zachariahsharma/puck/production/Puck_0.5.0_bom.csv

Designator | Footprint | Quantity | Value | LCSC Part #
C1 | C_0603 | 1 | 1 uF | C15849
C2 | C_0603 | 1 | 100nF | C19702
C3 | C_0603 | 1 | 4.7uF | C19702
C4 | C_0603 | 1 | 10uF | C19702
C5 | C_0603 | 1 | 1uF | C15849
C6 | C_0805 | 1 | 100nF | C28233
C7 | C_0603 | 1 | .1uF | C19702
J3 | HRO_TYPE-C-31-M-12 | 1 | TYPE-C-31-M-12 | C165948
LED1 | LED-SEG-TH_10P-L25.0-W19.0-P2.54-S15.2-BL | 1 | SN760561W/16 | C2980912
R3, R4 | R_0402 | 2 | 4.7kΩ | C25900
R5, R6 | R_0603 | 2 | 5.1kΩ | C23186
R7 | R_0603 | 1 | 10kΩ | C25804
SW1, SW2 | SW_PUSH_6mm_H7.3mm | 2 | SW_Push | B3F-4055
U1 | SOP-16_L10.0-W3.9-P1.27-LS6.0-BL | 1 | ET6226M | C347308
U3 | ESP32-C6-MINI-1 | 1 | ESP32-C6-MINI-1 | C5736265
U4 | SOT95P285X140-5N | 1 | AP2112K-3.3TRG1 | C51118
U5 | SOP65P490X110-8N | 1 | MCP9808T-E_MS | C129490
