zachariahsharma/puck/Comps/Models/ESP32-C6-MINI-1.STEP

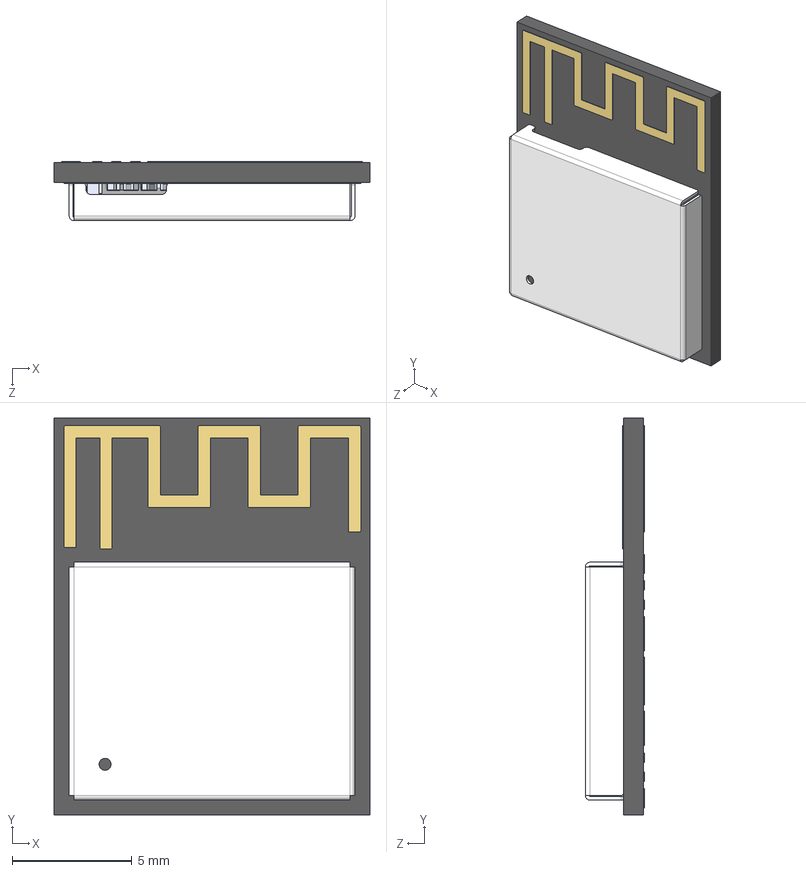
[picture p3: CAD file, 2026-06-09]
Comps/Models/ESP32-C6-MINI-1.STEP
13.2 x 16.6 x 2.48 mm
uid__2428
R0201_20210301.xtd x 3
L0201_20210301.xtd x 2
C0201_20210301.xtd x 10
ESP32-C6_QFN32_5X5_202306.xtd
XTAL3225_20210301.xtd
DFN1006.xtd
C0402_20210301.xtd
placementOutline_18
placementOutline_19
placementOutline_20
placementOutline_21
placementOutline_22
placementOutline_23
placementOutline_24
MINI-ANT-TYPE-D-H-top
MINI-ANT-TYPE-D-H-buttom
C3-MINI-solder_pad
ShieldBox_ESP32-C3-MINI-1_V1.0_20200901
