zachariahsharma/puck/Comps/Models/CP2102N-A02-GQFN28R.step

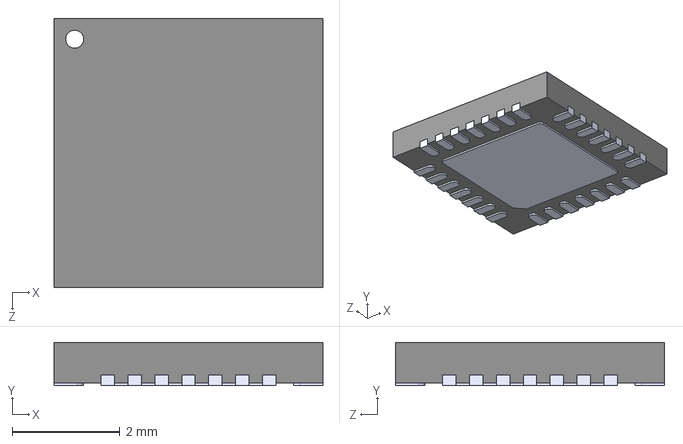
[picture p4: CAD file, 2026-04-08]
Comps/Models/CP2102N-A02-GQFN28R.step
5.00 x 0.8 x 5.00 mm
