zachariahsharma/puck/Comps/Models/AP2112K-3.3TRG1.step

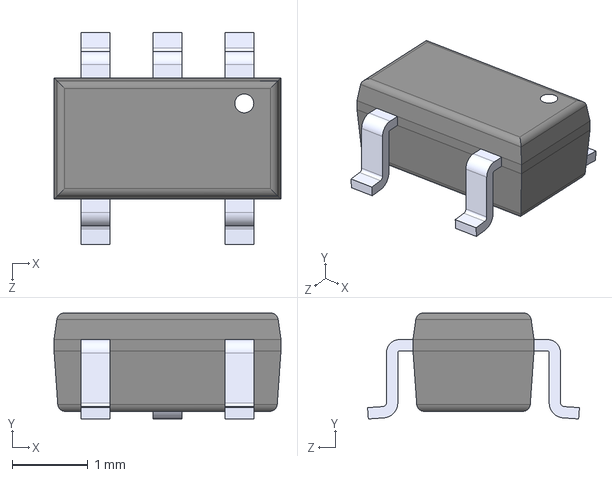
[picture p5: CAD file, 2026-04-08]
Comps/Models/AP2112K-3.3TRG1.step
3.00 x 1.40 x 2.80 mm
