zachariahsharma/puck/Comps/Models/TYPE-C-31-M-12.step

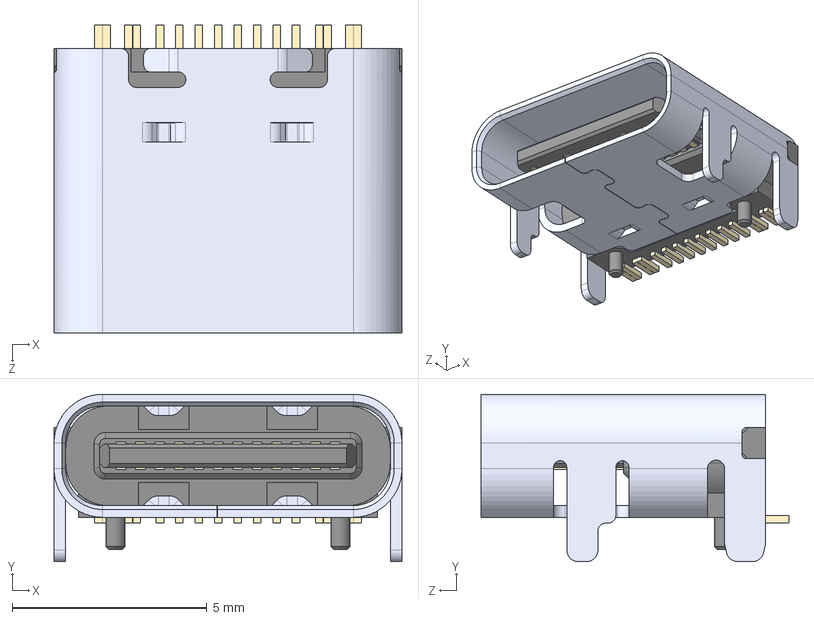
[picture p6: CAD file, 2026-04-08]
Comps/Models/TYPE-C-31-M-12.step
8.94 x 4.30 x 7.90 mm
