zachariahsharma/puck/Comps/Models/MCP9808T-E_MS.step

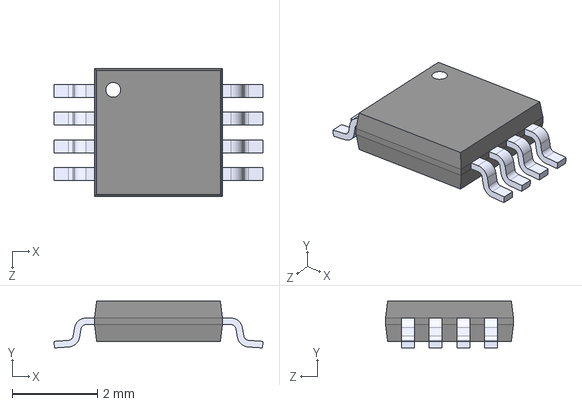
[picture p7: CAD file, 2026-04-08]
Comps/Models/MCP9808T-E_MS.step
4.90 x 1.10 x 3.00 mm
