zachariahsharma/puck/Puck.kicad_pcb

## KiCad design Puck.kicad_pcb (2026-10-26)

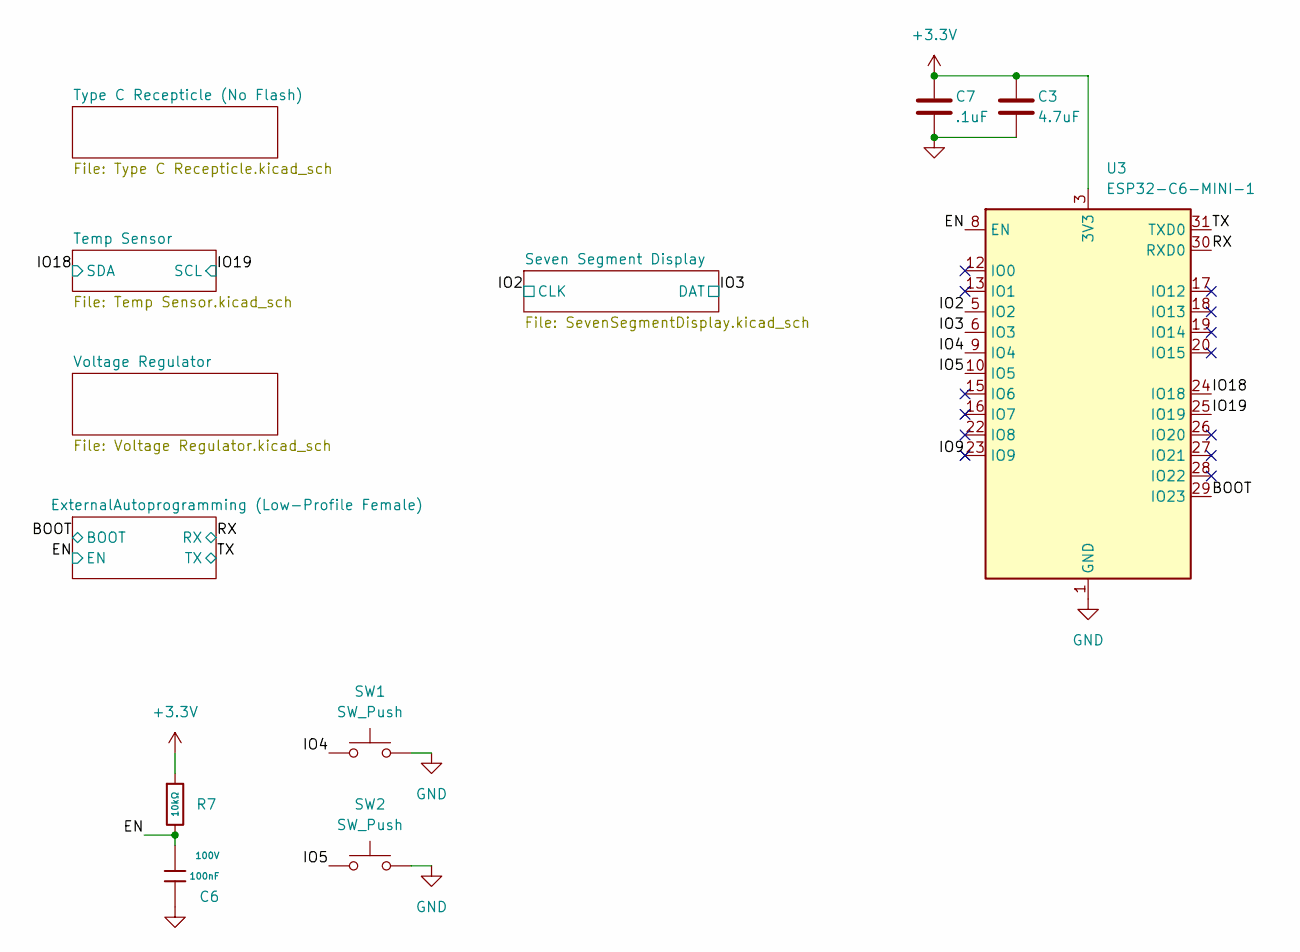
[picture p8: schematic Puck.kicad_sch, Vynte Puck]

Parts:
C3: 4.7uF; C_0603; MPN CL10A475KO8NNNC; DigiKey 1276-1784-2-ND
C6: 100nF; C_0805; Voltage Rated 100V; Tolerance ±10%; MPN CL21B104KCFNNNE; LCSC C28233
C7: .1uF; C_0603; MPN CL10B104KB8NNNC; DigiKey 1276-1000-2-ND
R7: 10kΩ; R_0603; Overload Voltage (Max) 75V; Tolerance ±1%; MPN 0603WAF1002T5E; LCSC C25804
SW1, SW2: SW_Push; SW_PUSH_6mm_H7.3mm; MPN B3F-4055; DigiKey SW414-ND
U3: ESP32-C6-MINI-1; MPN ESP32-C6-MINI-1-N4; LCSC C5736265

Connections:
+3.3V: C3.1, C7.1, R7.1, U3.3 (3V3); also elsewhere on the board
/BOOT: U3.29 (IO23); also elsewhere on the board
/EN: C6.1, R7.2, U3.8 (EN); also elsewhere on the board
/IO2: U3.5 (IO2); also elsewhere on the board
/IO3: U3.6 (IO3); also elsewhere on the board
/IO4: SW1.1, U3.9 (IO4)
/IO5: SW2.1, U3.10 (IO5)
/IO9: U3.23 (IO9)
/IO18: U3.24 (IO18); also elsewhere on the board
/IO19: U3.25 (IO19); also elsewhere on the board
/RX: U3.30 (RXD0); also elsewhere on the board
/TX: U3.31 (TXD0); also elsewhere on the board
GND: C3.2, C6.2, C7.2, SW1.2, SW2.2, U3.1 (GND), U3.2 (GND), U3.11 (GND), U3.14 (GND), U3.36 (GND), U3.37 (GND), U3.38 (GND), U3.39 (GND), U3.40 (GND), U3.41 (GND), U3.42 (GND), U3.43 (GND), U3.44 (GND), U3.45 (GND), U3.46 (GND), U3.47 (GND), U3.48 (GND), U3.49 (GND), U3.50 (GND), U3.51 (GND), U3.52 (GND), U3.53 (GND); also elsewhere on the board

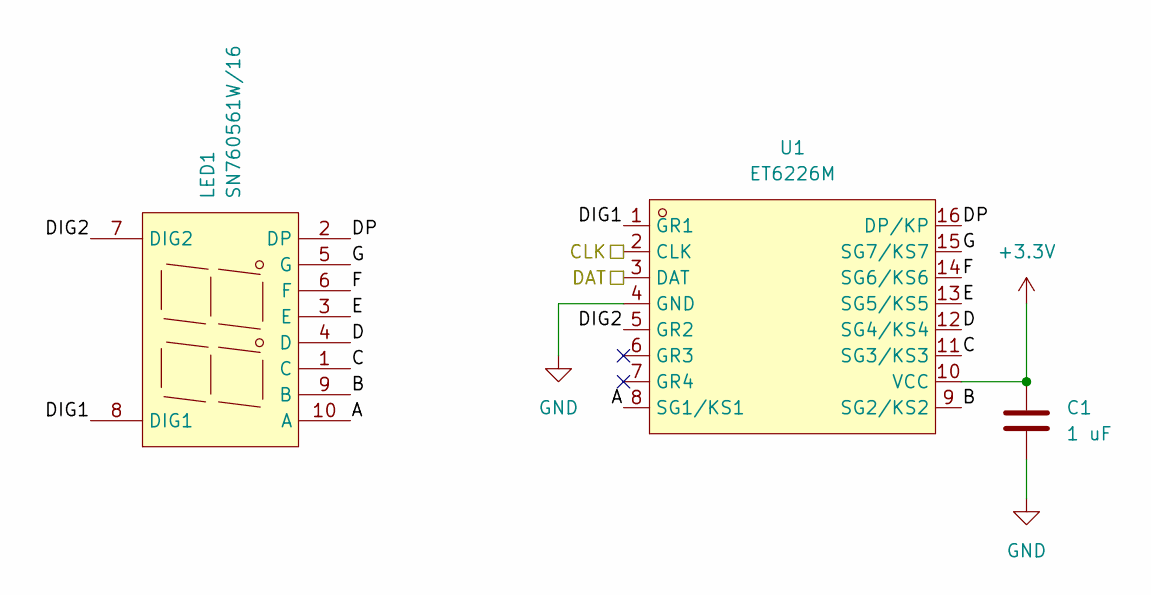
[picture p9: schematic SevenSegmentDisplay.kicad_sch]

Parts:
C1: 1 uF; C_0603; MPN CL10A105KB8NNNC; LCSC C15849
LED1: SN760561W/16; LED-SEG-TH_10P-L25.0-W19.0-P2.54-S15.2-BL; MPN SN760561W/16; LCSC C2980912
U1: ET6226M; SOP-16_L10.0-W3.9-P1.27-LS6.0-BL; MPN ET6226M; LCSC C347308

Connections:
+3.3V: C1.1, U1.10 (VCC); also elsewhere on the board
/IO2: U1.2 (CLK); also elsewhere on the board
/IO3: U1.3 (DAT); also elsewhere on the board
/Seven Segment Display/A: LED1.10 (A), U1.8 (SG1/KS1)
/Seven Segment Display/B: LED1.9 (B), U1.9 (SG2/KS2)
/Seven Segment Display/C: LED1.1 (C), U1.11 (SG3/KS3)
/Seven Segment Display/D: LED1.4 (D), U1.12 (SG4/KS4)
/Seven Segment Display/DIG1: LED1.8 (DIG1), U1.1 (GR1)
/Seven Segment Display/DIG2: LED1.7 (DIG2), U1.5 (GR2)
/Seven Segment Display/DP: LED1.2 (DP), U1.16 (DP/KP)
/Seven Segment Display/E: LED1.3 (E), U1.13 (SG5/KS5)
/Seven Segment Display/F: LED1.6 (F), U1.14 (SG6/KS6)
/Seven Segment Display/G: LED1.5 (G), U1.15 (SG7/KS7)
GND: C1.2, U1.4 (GND); also elsewhere on the board

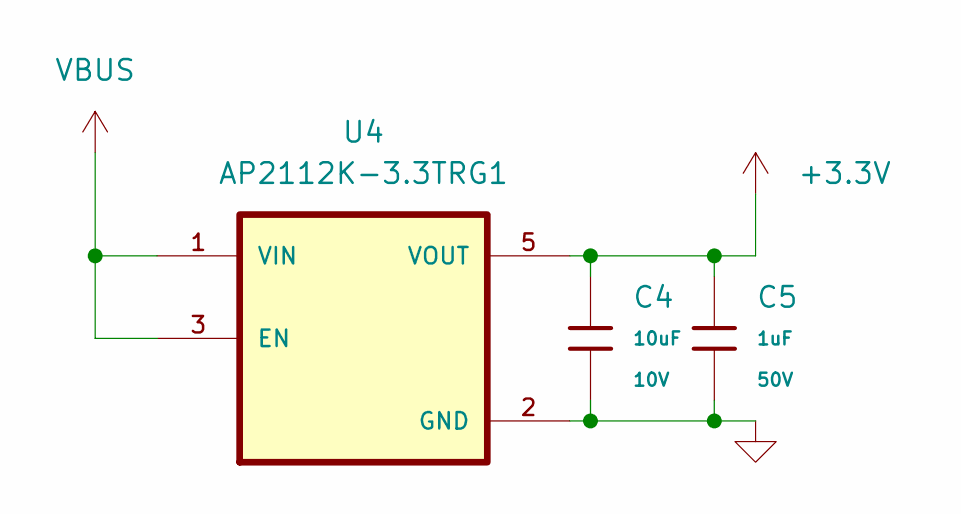
[picture p10: schematic Voltage Regulator.kicad_sch]

Parts:
C4: 10uF; C_0603; Voltage Rated 10V; Tolerance ±10%; MPN CL10A106KP8NNNC; LCSC C19702
C5: 1uF; C_0603; Voltage Rated 50V; Tolerance ±10%; MPN CL10A105KB8NNNC; LCSC C15849
U4: AP2112K-3.3TRG1; SOT95P285X140-5N; MPN AP2112K-3.3TRG1; LCSC C51118

Connections:
+3.3V: C4.1, C5.1, U4.5 (VOUT); also elsewhere on the board
GND: C4.2, C5.2, U4.2 (GND); also elsewhere on the board
VBUS: U4.1 (VIN), U4.3 (EN); also elsewhere on the board

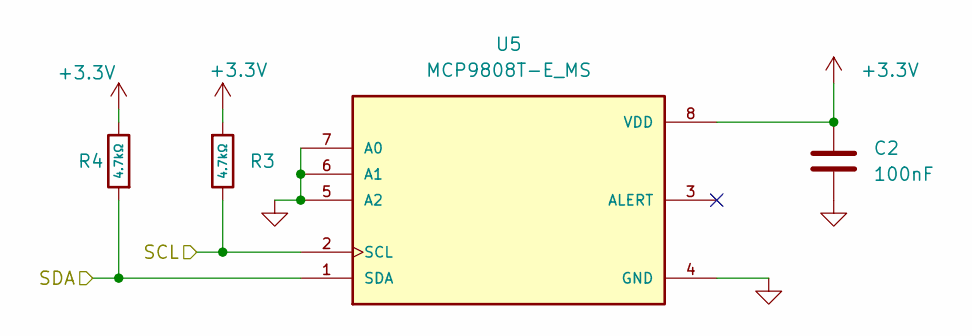
[picture p11: schematic Temp Sensor.kicad_sch]

Parts:
C2: 100nF; C_0603; MPN CL10B104KB8NNNC; DigiKey 1276-1000-2-ND
R3, R4: 4.7kΩ; R_0402; Overload Voltage (Max) 50V; Tolerance ±1%; MPN 0402WGF4701TCE; LCSC C25900
U5: MCP9808T-E_MS; SOP65P490X110-8N; MPN MCP9808T-E/MS; LCSC C129490

Connections:
+3.3V: C2.1, R3.1, R4.2, U5.8 (VDD); also elsewhere on the board
/IO18: R4.1, U5.1 (SDA); also elsewhere on the board
/IO19: R3.2, U5.2 (SCL); also elsewhere on the board
GND: C2.2, U5.4 (GND), U5.5 (A2), U5.6 (A1), U5.7 (A0); also elsewhere on the board

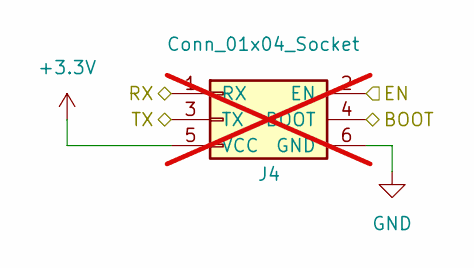
[picture p12: schematic ExternalAutoprogramming.kicad_sch]

Parts:
J4: Conn_01x04_Socket; Tag-Connect_TC2030-IDC-NL_2x03_P1.27mm_Vertical; not fitted

Connections:
+3.3V: J4.5 (VCC); also elsewhere on the board
/BOOT: J4.4 (BOOT); also elsewhere on the board
/EN: J4.2 (EN); also elsewhere on the board
/RX: J4.1 (RX); also elsewhere on the board
/TX: J4.3 (TX); also elsewhere on the board
GND: J4.6 (GND); also elsewhere on the board

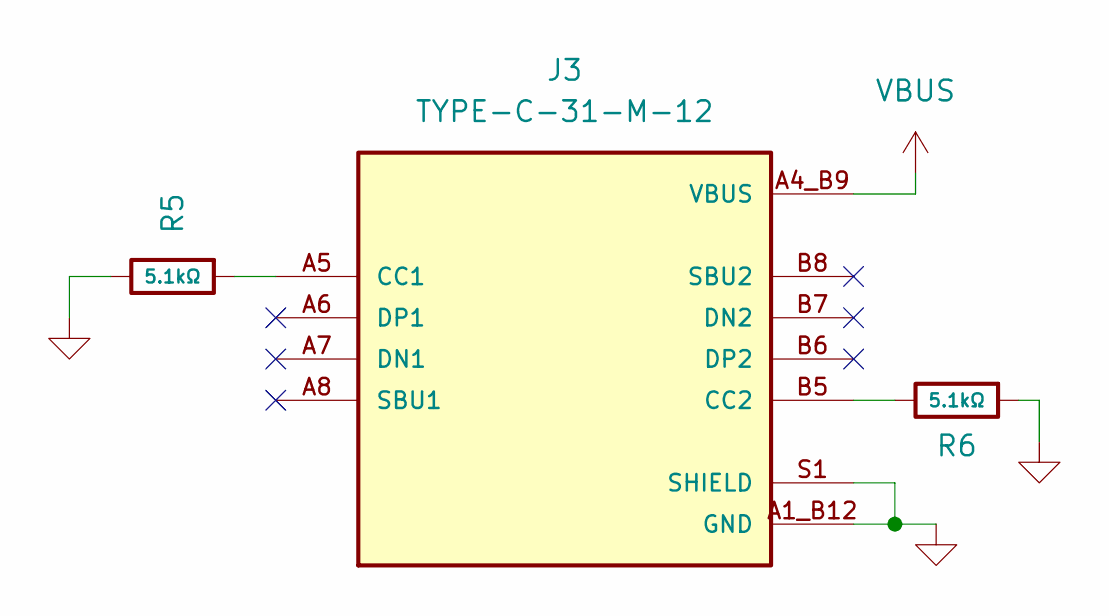
[picture p13: schematic Type C Recepticle.kicad_sch]

Parts:
J3: TYPE-C-31-M-12; HRO_TYPE-C-31-M-12; MPN TYPE-C-31-M-12; LCSC C165948
R5, R6: 5.1kΩ; R_0603; Overload Voltage (Max) 75V; Tolerance ±1%; MPN 0603WAF5101T5E; LCSC C23186

Connections:
GND: J3.A1_B12 (GND), J3.B1_A12 (GND), J3.S1 (SHIELD), J3.S2 (SHIELD), J3.S3 (SHIELD), J3.S4 (SHIELD), R5.2, R6.1; also elsewhere on the board
unnamed: J3.A5 (CC1), R5.1
unnamed: J3.B5 (CC2), R6.2
VBUS: J3.A4_B9 (VBUS), J3.B4_A9 (VBUS); also elsewhere on the board

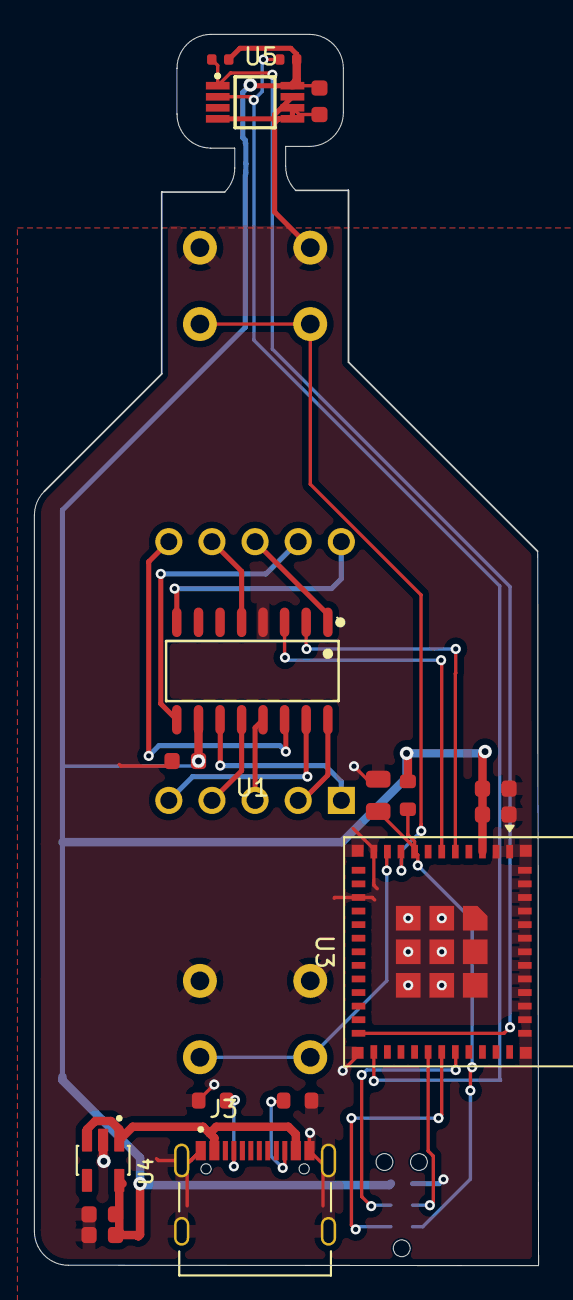
[picture p14: board Puck.kicad_pcb from above]

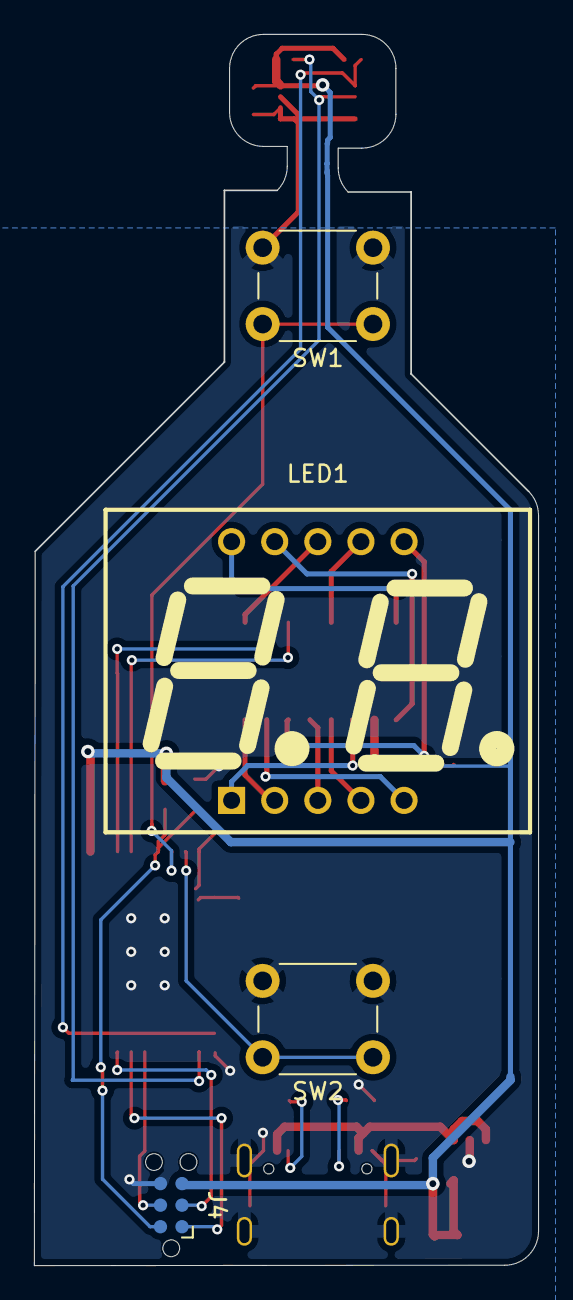
[picture p15: board Puck.kicad_pcb from below]

Board: 4 copper layers, 29.7 x 72.5 mm, 21 parts (4 on the bottom side), 25 nets.
