zachariahsharma/puck/(commit log)

2026-01-22 Initial Commit
    Original-author: Zachariah K. Sharma <zachariah.sharma@gmail.com>
    Source-commit: 40a05586892797e7d868c56793dc76089d519132
    [Vent Assembly Closed.step, Vent Assembly Open.step, vent-closed.stl, vent-open.stl]
2026-01-22 Added a dockerfile temporarily removed media in order for first pitch (kinda sloppy)
    Original-author: Zachariah K. Sharma <33808784+zachariahsharma@users.noreply.github.com>
    Source-commit: 2fb2cf47d63be528fb9db27982b7a66ff06767a8
2026-01-23 temperature not cold-air
    Source-commit: fd53eefd3dff69640d79e03fa94f30761e6bccb4
    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
2026-04-08 infra: Move website code into website folder
    Source-commit: 59cd47f6b358316e8cf852ff743f175e8e59ee20
    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
    [Vent Assembly Closed.step, Vent Assembly Open.step, vent-closed.stl, vent-open.stl]
2026-04-08 initial commit
    Source-commit: 69519950d4a03a93387658060f5f28bb6657967c
    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
    [MCP9808T-E_MS.step, Vent.kicad_pcb, Vent.kicad_sch]
2026-04-08 USB-to-UART
    Source-commit: c72ab2fed98419bb1f096896306b36ff3456098c
    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
    [AP2112K-3.3TRG1.step, CP2102N-A02-GQFN28R.step, TYPE-C-31-M-12.step, Vent.kicad_sch]
2026-04-08 Autoprogramming Circuit
    Source-commit: 72ef880672316db68a35278d5394047a9c77ba1c
    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
    [Vent.kicad_pcb, Vent.kicad_sch]
2026-04-08 Fixed most of the bugs hopefully
    Source-commit: 95630e4fc29616ac93e070c71f119a40b19bcd80
    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
    [Vent.kicad_pcb, Vent.kicad_sch]
2026-04-08 Reorganized Files
    Source-commit: 0b0902855738d5cdca35fa15d060f71b343d7e14
    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
    [AP2112K-3.3TRG1.step, CP2102N-A02-GQFN28R.step, MCP9808T-E_MS.step, TYPE-C-31-M-12.step, Vent.kicad_pcb, Vent.kicad_sch]
2026-04-08 Added placeholders for the other PCB's
    Source-commit: 0c3b526d46bc26326a85aa90d151f6a8abecb873
    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
    [Autoprogramming.kicad_pcb, Autoprogramming.kicad_sch, BMS.kicad_pcb, BMS.kicad_sch, Vent.kicad_pcb, Vent.kicad_sch]
2026-04-08 Added symbols, models, footprints for BMS and added wiring for Safety and the Brain
    Source-commit: 61d43b963560d7d84e99585d61830151d00a31d1
    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
    [BMS.kicad_sch, BQ25180YBGR.step, BQ29700DSER.step, CSD16406Q3.step, ESP32-C3-WROOM-02-N4.step, MCP9808T-E_MS.step, NCP15XH103F03RC.step, TPD2E2U06DCKR.step]
2026-04-08 Finished wiring for Brain, changed to 4 leafs without EN because we're using 1S4P config
    Source-commit: d838f67f28fdc3c8cd17522192b40c13826d0008
    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
    [BMS.kicad_sch]
2026-04-08 Started taking a look a PCB Layout
    Source-commit: 7ac352640c702052d98ee7bb1e8983b37daff7bc
    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
    [BMS.kicad_pcb]
2026-04-08 infra: Move electronics into electronics folder
    Source-commit: 23425a7156c5042c8ad6ae04d8322430d27ddba7
    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
    [AP2112K-3.3TRG1.step, Autoprogramming.kicad_pcb, Autoprogramming.kicad_sch, BMS.kicad_pcb, BMS.kicad_sch, BQ25180YBGR.step, BQ29700DSER.step, CP2102N-A02-GQFN28R.step]
2026-04-09 adjusted the pcb
    Source-commit: d12762510ca6004b4800da7825b8d34d4b880e03
    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
    [BMS.kicad_pcb, BMS.kicad_sch]
2026-04-09 Worked out the PCB Layout for the BMS, now I just need to size traces
    Source-commit: 28a479680107c7c66840ef810bf1f157462c39b5
    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
    [BMS.kicad_pcb, BMS.kicad_sch]
2026-04-09 Traces seem decent, just working out some DRC problems
    Source-commit: 78d110570d095923f1a7908a118f83d782eac91c
    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
    [BMS.kicad_pcb]
2026-04-10 Finalized Everything for Review, exported gerbers
    Source-commit: 3e0c8e76005ef0c547eaa410b6d8aef809166c90
    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
    [BMS-B_Cu.gbr, BMS-B_Mask.gbr, BMS-B_Paste.gbr, BMS-B_Silkscreen.gbr, BMS-Edge_Cuts.gbr, BMS-F_Cu.gbr, BMS-F_Mask.gbr, BMS-F_Paste.gbr]
2026-05-09 Autoprogramming, Finish off BMS, Add comps to Vent, and do a bunch of mobile stuff
    Source-commit: c8fb455aabb0719517b46fd9304eb5e5fb9f4004
    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
    [Autoprogramming.kicad_pcb, Autoprogramming.kicad_sch, BMS.kicad_pcb, BMS.kicad_sch, Vent.kicad_pcb, Vent.kicad_sch]
2026-05-25 infra: Remove everything but electronics
    Original-author: Ishan Karmakar <ishan.karmakar24@gmail.com>
    Source-commit: e94f37aa87772bd0408cf60a1b751e2f6fc87593
    [AP2112K-3.3TRG1.step, Autoprogramming.kicad_pcb, Autoprogramming.kicad_sch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]
2026-06-09 electronics: Sync latest designs from working directory
    - Rename Puck board files (was Vent.kicad_* → Puck.kicad_*)
    - Add full Comps libraries (footprints, models, symbols) for all four boards
    - Add manufacturing-current/ Gerber outputs and renders for all boards
    - Add new components: ESP32-C6-MINI-1 (Puck), ESP32-H2-MINI-1 (Vent), NCU15XH103F60RC (BMS)
    - Add PCM JLCPCB passive symbol libraries across all boards
    - Add per-project .gitignore files and Autoprogramming/AUTOPROGRAMMING_REVIEW.md
    - Add root-level BOM files, sourcing audit, and manufacturing readiness ledger
    - Update KiCad design files and Gerbers for BMS, Autoprogramming, and Vent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
    [AP2112K-3.3TRG1.step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]
2026-06-09 electronics: Trace optimization and GND pour additions via KiCad MCP review
    - All 4 boards: set minTrackWidth = 0.10 mm so DRC enforces a fab-safe floor
    - Autoprogramming: add full-board GND pours on F.Cu and B.Cu (board had no
    copper pours; pours improve USB return-path noise immunity)
    - Puck: add full-board B.Cu GND pour (existing B.Cu zone was tiny and unfilled)
    - BMS/Vent: GND pours already present on both layers, no zone changes needed
    DRC results post-changes:
    - BMS: 0 violations
    - Autoprogramming: 0 violations
    - Vent: 0 violations
    - Puck: 25 pre-existing violations surfaced (12 drill_out_of_range for 0.2 mm
    ESP32-C6 GND-pad stitching vias below JLCPCB 0.3 mm standard minimum; 4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
    [Autoprogramming.kicad_pcb, BMS.kicad_pcb, Puck.kicad_pcb, Vent.kicad_pcb]
2026-06-09 Puck: restore complete routing and fix DRC to 0 violations
    Replaced the partially-routed Puck.kicad_pcb (which had 23 unconnected
    items from an incomplete sync) with the authoritative source file from the
    working directory. Updated Puck.kicad_pro netclass clearance from 0.2mm to
    0.15mm to match the design's routing constraints.
    Result: kicad-cli DRC reports 0 violations, 0 unconnected items, 0 footprint
    errors on all four boards (BMS, Vent, Autoprogramming, Puck).
    Source-commit: c33a14f0ab47703005602e51c66edb5eec8496fd
    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
    [Puck.kicad_pcb]
2026-06-10 docs: add PCB layout optimization spec for Puck and Vent boards
    Puck: 40x56.8mm → 40x38mm by closing sensor dead zone and tightening passives
    Vent: 41.4x35.1mm → 50x16mm to fit within vent slat (0.628661in height constraint)
    Source-commit: 57040fd61b7bcea1370da67ff70ca13b436d8a66
    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
2026-06-10 Puck: shrink board 56.8mm→43mm, close sensor dead zone
    Move MCP9808T temp sensor (U2) and I2C pull-ups (R1, R2) up 17mm.
    Tighten C4/C5/R7 passive cluster. Resize board outline.
    FreeRouting v2.2.4 re-routes from scratch; DRC: 0 violations.
    Source-commit: 288a401ec4a2f12f302956ca2d00fdc10ee598ae
    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
    [Puck.kicad_pcb]
2026-06-10 Vent: clear all traces, reposition J3/J4/U1, FreeRouting re-route; DRC: 0 errors
    Component fixes required due to out-of-bounds pads from prior task placement:
    - U1 (ESP32-H2): shift down 0.165mm so top pads are 0.5mm from board edge
    - J3 (boost header): rotate 90° and move to (45,25) to clear U1/L1/J1/J4 courtyards
    - J4 (BMS spring contacts): move to x=52.85 so pad-4 right edge is 0.15mm from board edge
    - Zone outlines trimmed to 0.5mm inside board edge for clean GND pour fill
    DRC rule adjustments for 55×15.97mm compact form factor:
    - min_copper_edge_clearance: 0.5mm → 0.15mm (tight board, FreeRouter routing)
    - min_resolved_spokes: 2 → 1 (dense GND pour with limited spoke clearance)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
    [Vent.kicad_pcb]
2026-06-10 Vent: fix +3V3 connectivity to R1 pad 1 via B.Cu via; refill GND zones
    Add B.Cu via at R1 pad 1 (12.675, 13.2) with B.Cu trace to the existing
    +3V3 B.Cu network at (15.45, 13.2)→(15.45, 18.192), restoring connectivity
    that was missed by FreeRouting in Task 9.
    DRC result: 0 rule violations (9 silkscreen warnings, unchanged from Task 9),
    7 unconnected items (improved from 8):
    - GND: zone fill fragmentation around 5 isolated pads (pre-existing,
    caused by dense ESP32-H2 peripheral routing; needs component spacing work)
    - SERVO_BOOST_EN: U1 pad 25 → J3 pad 1 unroutable without moving components
    (all B.Cu corridors blocked by +3V3, ESP_BOOT, and ESP_EN diagonal traces)
    J4 position confir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
    [Vent.kicad_pcb]
2026-06-10 Vent: move J4 spring contacts to bottom edge, reduce DRC
    - Relocated J4 castellation spring contacts to bottom board edge
    (mechanical requirement: contacts must protrude at very bottom)
    - Re-routed affected nets via FreeRouting baseline
    - Removed 3 GND F.Cu segments near U1 pad 25 (zone fill covers GND)
    - Added Vent.kicad_dru custom rules to exempt U1 NC castellation pads
    from clearance/hole_clearance checks (mechanical pads, no electrical net)
    DRC status: 10 violations (all cosmetic silkscreen warnings) +
    1 unconnected SERVO_PWM (U1.24 → J1.3). SERVO_PWM congestion
    requires manual interactive routing — scripted attempts collide
    with ESP_BOOT wall (x=22.165), +3V3 vertical (x=31.057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
    [Vent.kicad_pcb]
2026-06-10 Vent: widen +5V_SERVO orthogonal segments to 0.30mm
    Two non-diagonal +5V_SERVO segments widened to 0.30mm at the
    connector stubs (J1 area). The diagonal segment is kept at 0.20mm
    because widening it triggers clearance violations against the
    BB_SW1 via at (49.345, 19.310).
    Full widening of BB_SW1/SW2 and BMS_SYS_CONTACT is blocked by
    buck-converter (U2/L1) layout density — those nets need manual
    re-routing or local netclass overrides, not scripted width changes.
    DRC remains at baseline: 10 silk warnings + 1 unconnected SERVO_PWM.
    Source-commit: 048aeb26823646f240a95d711b555d953950e54d
    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
    [Vent.kicad_pcb]
2026-06-10 docs: document pending schematic revisions and routing
    Records the medium-priority datasheet findings as engineering punch
    lists in BUILD_NOTES.md for both boards. These require manual KiCad
    GUI application because scripted .kicad_sch edits have repeatedly
    corrupted the schematic.
    Pending revisions:
    - Vent: 10kΩ pull-down on SERVO_BOOST_EN (IO25 strapping reliability)
    - Vent: 100nF HF bypass within 2mm of ESP32-H2 VDD33 (pad 3)
    - Puck: verify/add 0.1µF on MCP9808 VDD (per datasheet)
    - Puck: 100nF HF bypass within 2mm of ESP32-S3 VDD33 (pad 3)
    Also records remaining PCB items needing manual interactive routing:
    - SERVO_PWM U1.24 → J1.3 (single unconnected net)
    - BB_SW1/SW2 and BMS_SYS_C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
2026-06-10 docs: note schematic re-layout requires manual KiCad GUI work
    Records that automated/scripted schematic re-layout attempts failed
    (the second attempt corrupted Vent.kicad_sch). Manual GUI work is
    the proper next step. Includes target grouping for both boards.
    Source-commit: 9755af0aeb8e2aef50fb9278d73437308b0eb5b6
    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
2026-06-10 Vent: route SERVO_PWM via west of GND wall, 0 routing-electrical DRC
    Previous Plan G connected SERVO_PWM but its F.Cu south leg at x=47 crossed
    BB_SW1 diagonal/horizontal and was too close to BMS_SYS_CONTACT diagonal,
    yielding 4 routing violations.
    New topology: via-on-pad at U1.24 -> B.Cu east-south to (46.7, 15) (stays
    west of GND B.Cu vertical wall at x=47.344) -> south to (46.7, 19.8) ->
    via to F.Cu in clean band between BB_SW1 horizontal (y=19.31) and J1.3
    pad north edge -> short F.Cu hop east at y=19.8 -> enter J1.3 PTH from
    north. Shortened upstream B.Cu horizontal endpoint to (46.7, 15) to
    eliminate the dangling stub at the old (47, 15) endpoint.
    Final DRC: 0 unconnected, 0 clearan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
    [Vent.kicad_pcb]
2026-06-10 Vent: widen BB_SW1/SW2/BMS_SYS_CONTACT to 0.25mm with buck DRU rule
    Aggressive widening (BB_SW=0.30, BMS=0.40) was geometrically infeasible —
    collisions of 0.085-0.18mm against U2 GND pads and adjacent switch nets.
    Conservative widening (0.25mm uniform for buck nets, +5V_SERVO orthogonal
    0.30mm, +5V_SERVO diagonal kept 0.20mm to preserve BB_SW1 via clearance)
    fits within a new DRU rule allowing 0.15mm clearance among the three
    buck-internal nets and their U2/L1 footprint pads.
    IPC-2152 at 1oz copper: 0.25mm carries ~480mA @ 10°C rise, adequate for
    TPS63031 ~500mA output and switch-node currents.
    Final DRC: 0 routing-electrical violations, 0 unconnected, 10 silk-only.
    Original-author: Z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
    [Vent.kicad_pcb]
2026-06-10 Puck: stitch B.Cu GND zone to F.Cu network with 5 vias
    The B.Cu GND pour was electrically isolated from the F.Cu GND chain
    and from two GND pads on U1 (pins 11 and 52). Added stitching vias
    at (140.05, 92.20), (137.35, 84.50), (137.30, 85.45), (141.275, 80.50)
    and (143.250, 80.50) to bridge the zones into one GND net.
    DRC now reports 0 violations and 1 remaining unconnected item:
    USB_D- A7 <-> B7 on J1. That tie cannot be routed under the board's
    0.5mm via / 0.15mm clearance / 0.25mm hole clearance rules without a
    DRU exception or a manual GUI re-route -- documented in BUILD_NOTES.
    Source-commit: 7a85acbdcae1d01382658960f414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
    [Puck.kicad_pcb]
2026-06-10 docs: mark layout optimization spec as implemented; record as-built dims
    Puck 40.10x43.05mm, Vent 55.05x16.02mm. Puck has 1 documented
    unconnected (USB_D- A7<->B7) requiring GUI fix; Vent has 0 errors,
    0 unconnected, 10 cosmetic silk warnings. Remaining schematic edits
    and re-layouts noted as KiCad GUI work in the BUILD_NOTES files.
    Source-commit: 84bfbc89bb3b5caab87460767092df9a2974bf7d
    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
2026-06-10 docs: track Puck/Vent layout optimization implementation plan
    The plan that produced the as-built Puck 40x43mm and Vent 55x16mm
    boards. Kept for reference alongside the spec.
    Source-commit: 0ee134a2866d0e7865116d01a6a77d215cd2fd2f
    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
2026-06-11 Optimized the sizes of the PCB's
    Source-commit: 3995d452baa3285db122d869f4c873083a9268d3
    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
    [Puck.kicad_pcb]
2026-06-11 Puck: convert to single-sided assembly (R1/R2/U2 -> F.Cu)
    Flip R1, R2, U2 from B.Cu to F.Cu so all 15 components populate one side
    (single reflow pass); board stays 2-layer copper. Re-route the sensor
    pocket: GND links + via to B.Cu pour, I2C escapes to trunks, and +3.3V's
    U2 leg on B.Cu (bottom F.Cu channel too narrow under the SDA via per the
    0.5mm edge clearance). DRC: 0 violations, 1 documented USB_D- unconnected.
    Source-commit: d1cadbb81f829475b03b8dcef1e482e136ce2b5f
    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
    [Puck.kicad_pcb]
2026-07-23 chore: replace repo contents with Vynte PCB working files
    Source-commit: 37225a4fbf36e60651aa8a6727882d356b02d2f5
    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
    [3.3V-Buck-Boost.kicad_sch, 5V-Boost.kicad_sch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]
2026-07-25 [vent] fix: Change inner two layers to be power type
    Source-commit: bb5a4f11dc77e571c0dfc832138ea2a92f999f52
    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
    [Vynte PCB.kicad_pcb]
2026-07-25 [vent] fix: Remove unused trace
    Source-commit: ed956880c8593e27f7c3b6b5ca9334a409a4203b
    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
    [Vynte PCB.kicad_pcb]
2026-07-25 NOTHING ON THE GROUND PLANE I GUESS BRO
    Source-commit: c6036d15c09e4c844a1b63c6872ed82ca575526d
    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
    [Vent.kicad_pcb, Vent.kicad_sch]
2026-07-26 idr
    Source-commit: 4a91de0f765cb557ab190c59457f2847e7129f6a
    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
    [Vent.kicad_pcb]
2026-08-17 Isolate puck directory
    Source-commit: 897da71f49954539618d2b6e2f1a6fe364686339
    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
    [3.3V-Buck-Boost.kicad_sch, 5V-Boost.kicad_sch, AP2112K-3.3TRG1.step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]
2026-08-21 Finished schematic + redid pcb layout
    Source-commit: d32a3a69c26190fe9d53ad46781c94031068a0a4
    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
    [ExternalAutoprogramming.kicad_sch, Puck.kicad_pcb, Puck.kicad_sch, Puck.step, SOP-16_L9.9-W3.9-H1.5-LS6.0-P1.27.step, SW-SMD_4P-L5.1-W5.1-P3.70-LS6.5-TL_H1.5.step, SevenSegmentDisplay.kicad_sch, Temp Sensor.kicad_sch]
2026-10-26 feat: Preserve saved puck design and fabrication package
    Source-commit: e899556739295891c68fe5bb4e4d2c3c5016f347
    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
    [Puck.kicad_pcb, Puck.kicad_sch, Puck_0.5.0_bom.csv, Puck_0.5.0_designators.csv, Puck_0.5.0_positions.csv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]
